xonik/waveshaper-pcb/Xonik Waveshaper v2.2-brd.md

# Xonik Waveshaper v2.2

### Board top
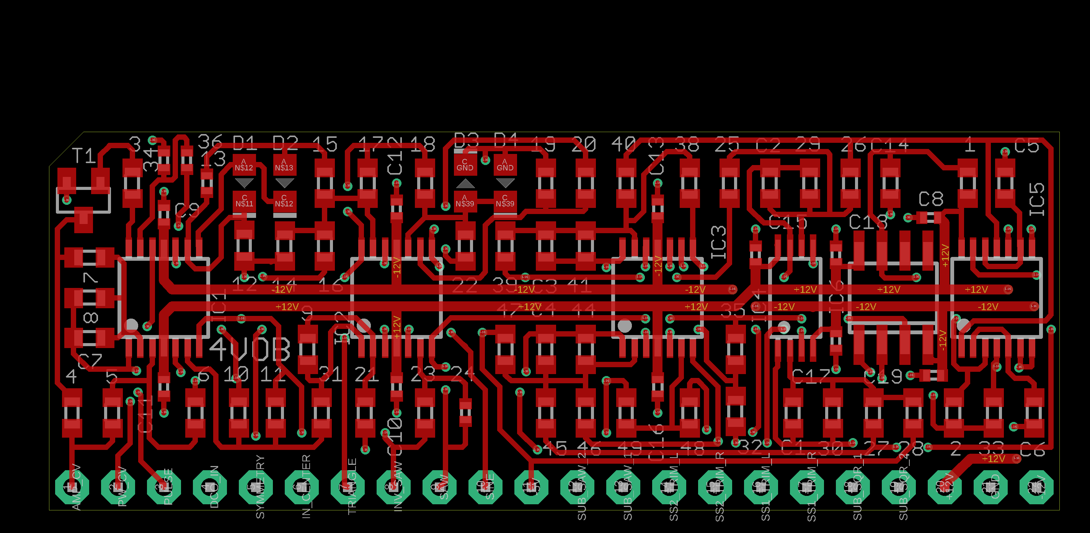
[picture p1: Xonik Waveshaper v2.2-brd-top.png]
Top side

### Board bottom
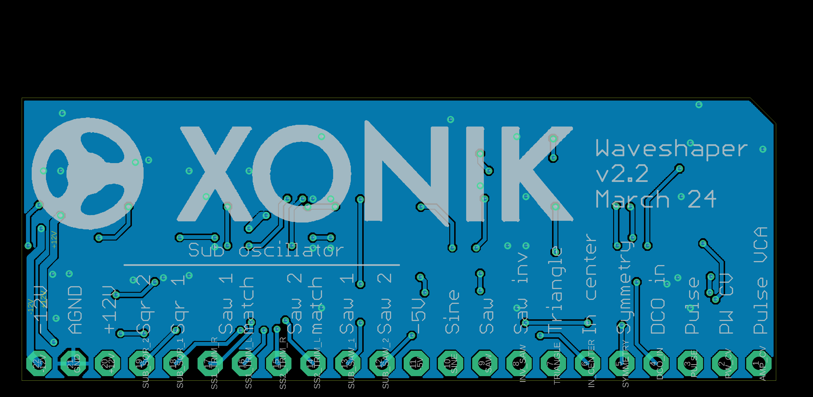
[picture p2: Xonik Waveshaper v2.2-brd-bottom.png]
Bottom side
