xonik/waveshaper-pcb/Xonik Waveshaper v2.4-brd.md

# Xonik Waveshaper v2.4

### Board top
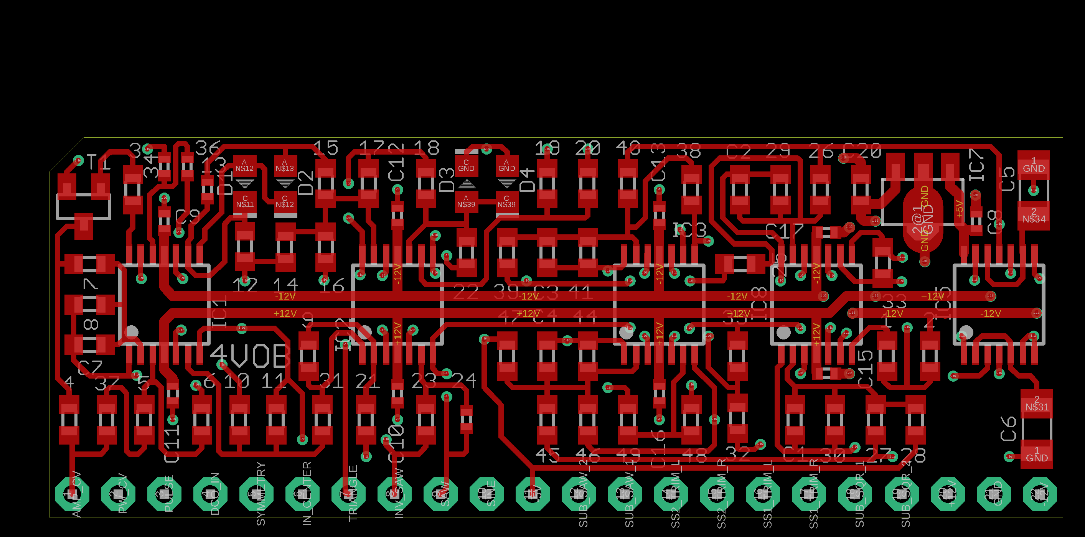
[picture p3: Xonik Waveshaper v2.4-brd-top.png]
Top side

### Board bottom
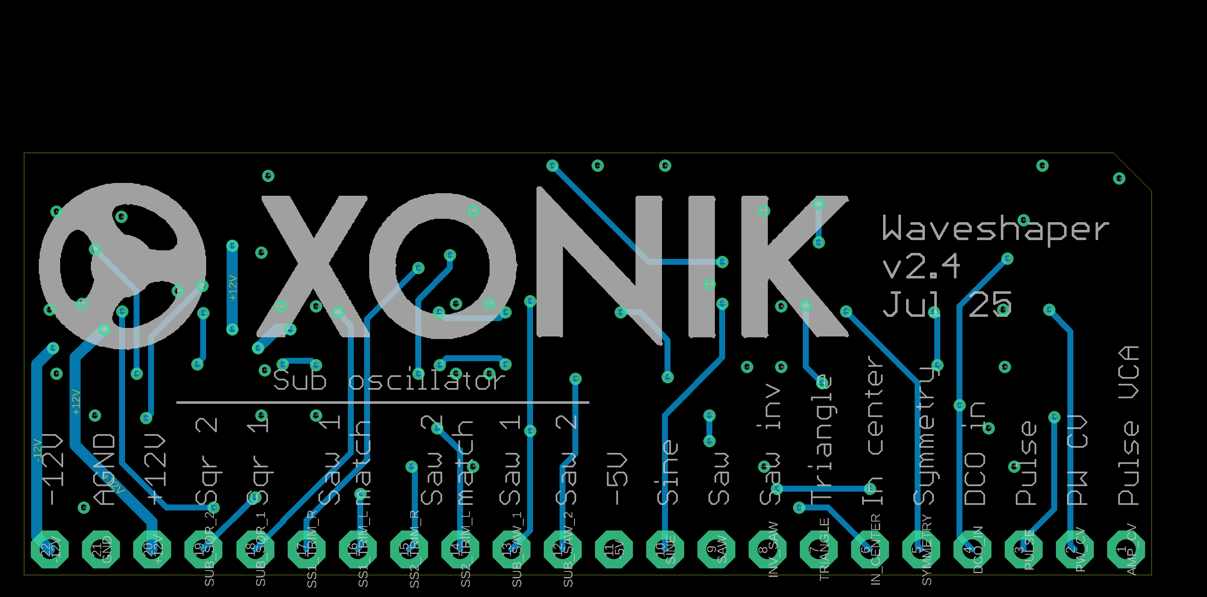
[picture p4: Xonik Waveshaper v2.4-brd-bottom.png]
Bottom side
