xonik/waveshaper-pcb/attic/Xonik Waveshaper v2.1-brd.md

# Xonik Waveshaper v2.1

### Board top
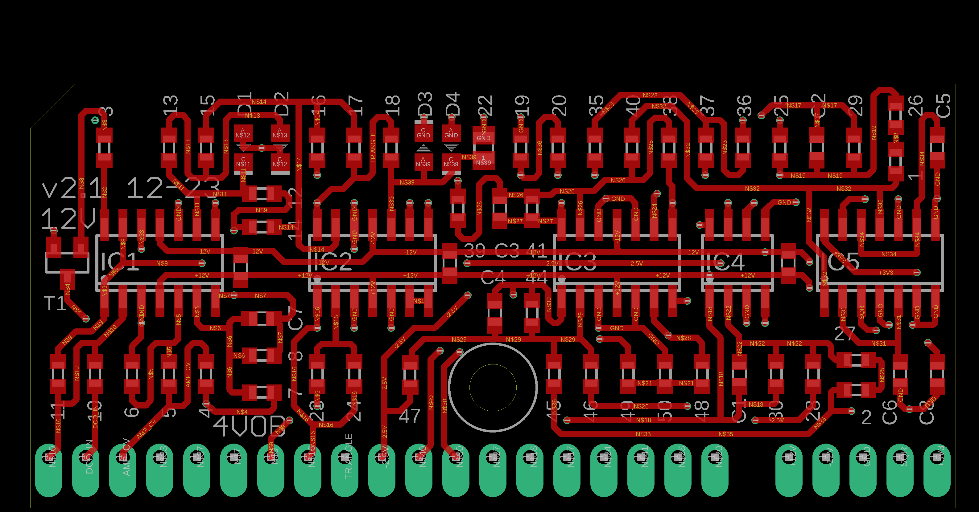
[picture p5: attic/Xonik Waveshaper v2.1-brd-top.png]
Top side

### Board bottom
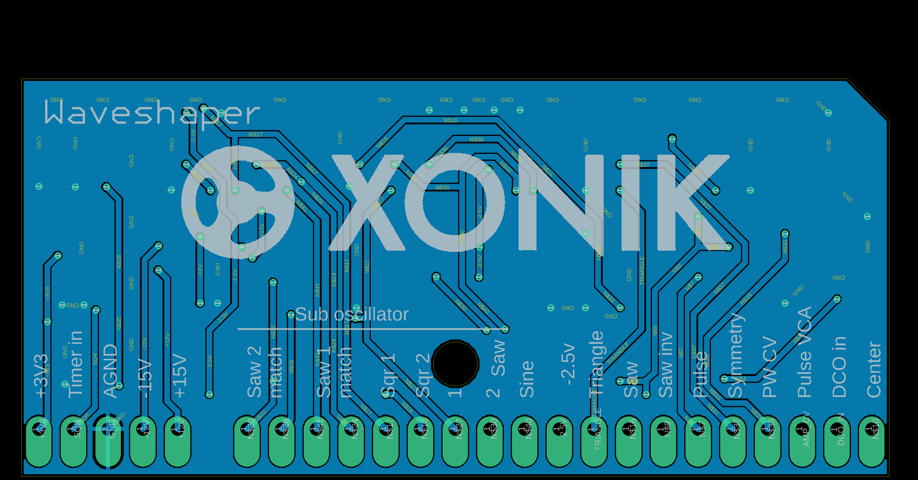
[picture p6: attic/Xonik Waveshaper v2.1-brd-bottom.png]
Bottom side
