xonik/waveshaper-pcb/Xonik Waveshaper v2.4-sch.md

# Xonik Waveshaper v2.4

### Sheet 1

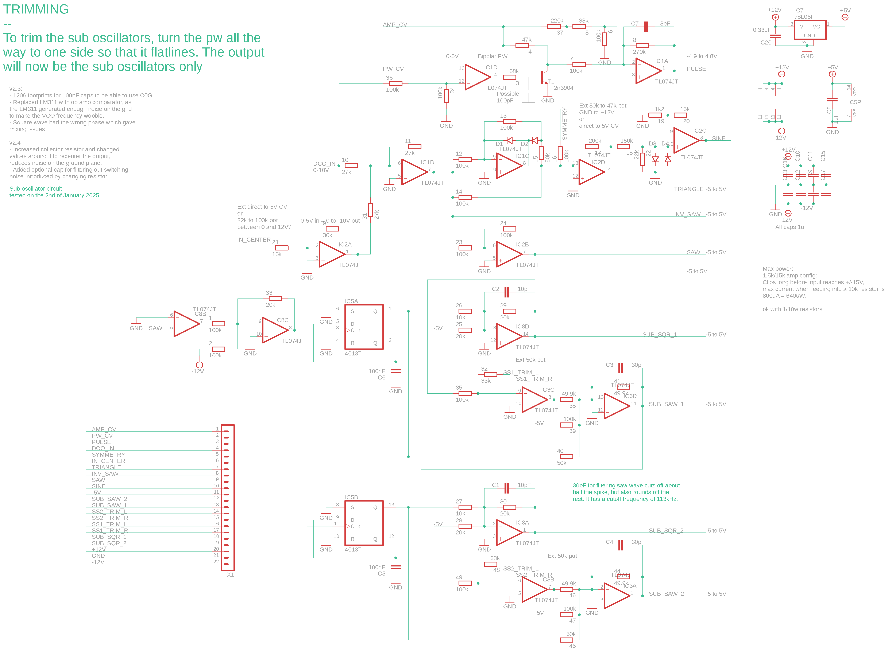
[picture p7: Xonik Waveshaper v2.4-sch-1.png]
Top side
