xonik/waveshaper-pcb/attic/Xonik Waveshaper v2.1-sch.md

# Xonik Waveshaper v2.1

### Sheet 1

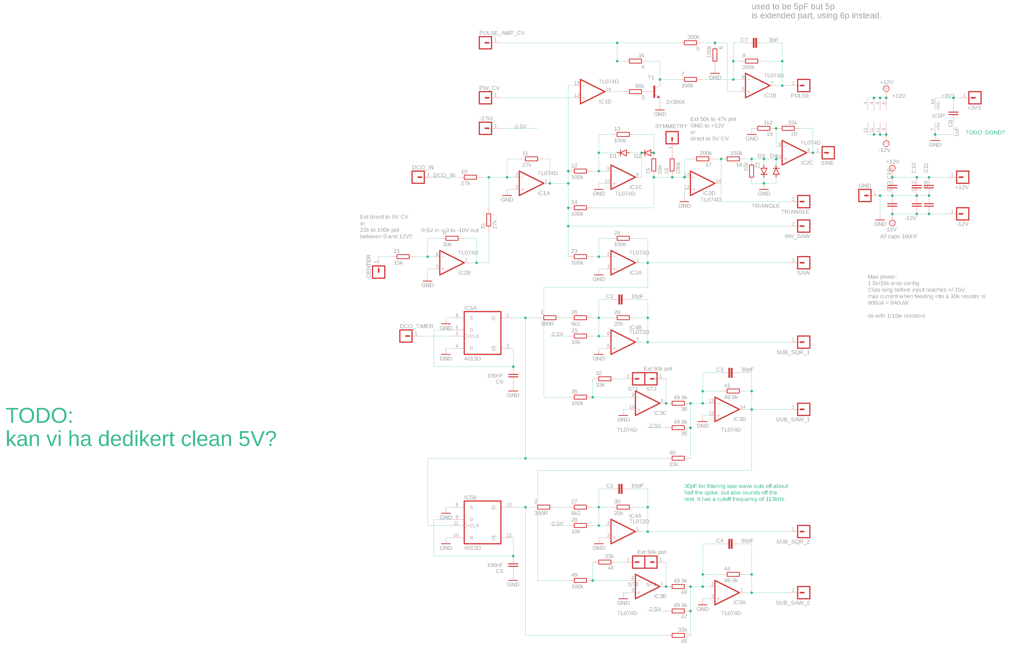
[picture p8: attic/Xonik Waveshaper v2.1-sch-1.png]
Top side
