xonik/waveshaper-pcb/Xonik Waveshaper v2.3-brd.md

# Xonik Waveshaper v2.3

### Board top
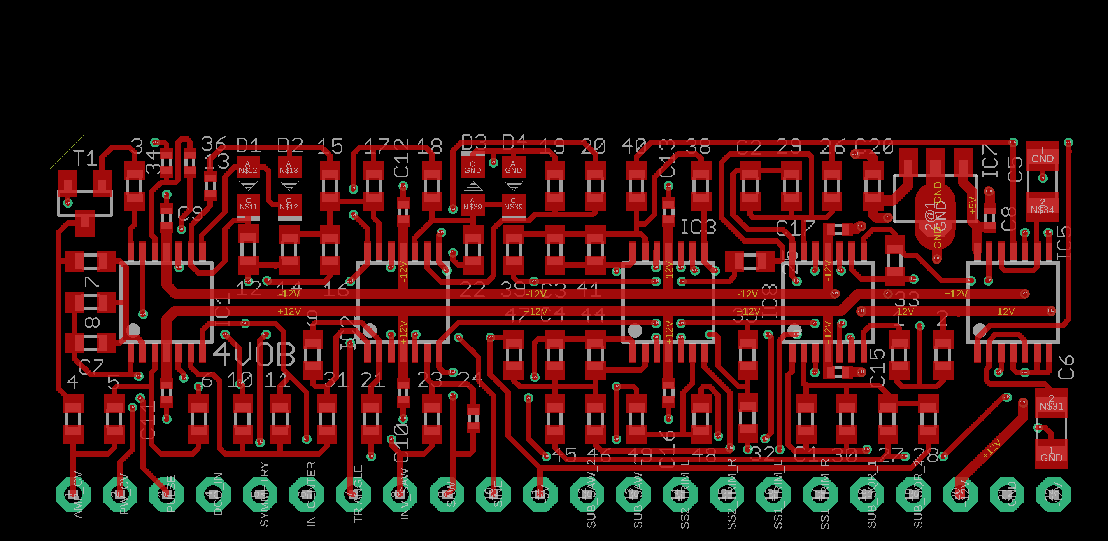
[picture p9: Xonik Waveshaper v2.3-brd-top.png]
Top side

### Board bottom
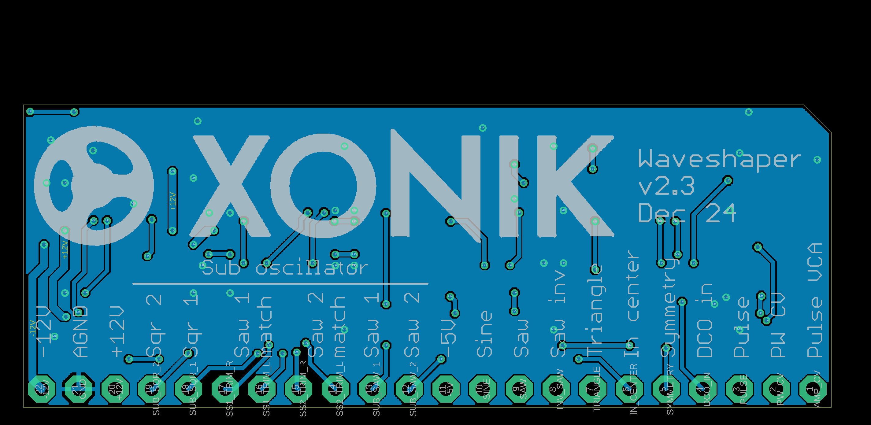
[picture p10: Xonik Waveshaper v2.3-brd-bottom.png]
Bottom side
