xonik/waveshaper-pcb/Xonik Waveshaper v2.3-sch.md

# Xonik Waveshaper v2.3

### Sheet 1

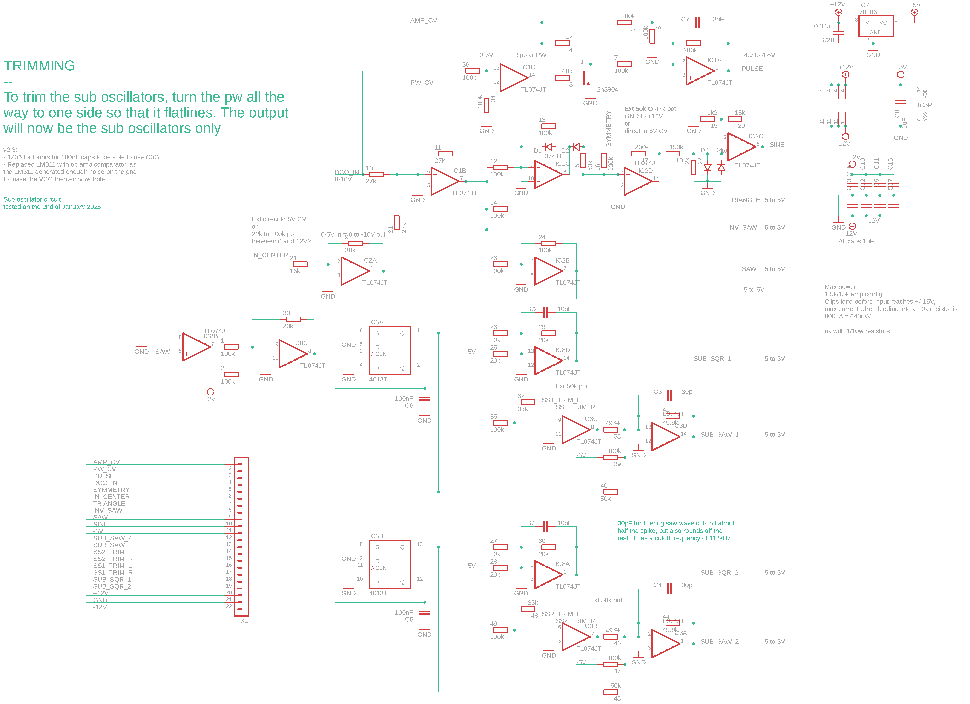
[picture p11: Xonik Waveshaper v2.3-sch-1.png]
Top side
