xonik/waveshaper-pcb/Xonik Waveshaper v2.2-sch.md

# Xonik Waveshaper v2.2

### Sheet 1

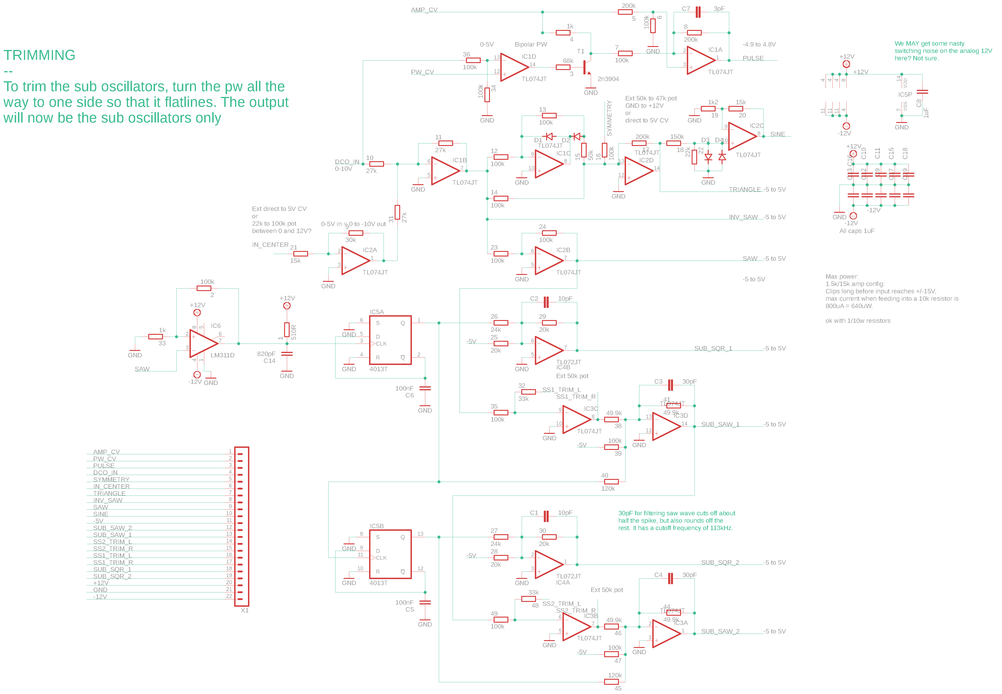
[picture p12: Xonik Waveshaper v2.2-sch-1.png]
Top side
