xonik/waveshaper-pcb/Extended parts.txt

Extended parts, Waveshaper:

50k - C63865
CD4013 - C347580
TL074D

Missing from bom
TL074, IC1,2,3

Wrong rotation:
T1, is 180, should be 90
D1,2,3,4 swapped +/-
