xonik/waveshaper-pcb/Xonik Waveshaper v2.4_top_bom.csv

Comment | Designator | Footprint | LCSC Part #
MA22N-1J | X1 | MA22N-1J
0.33uF | C20 | C0603-J
1N41480805 | D1 D2 D3 D4 | D0805-J
1k2 | 19 | R0603
1uF | C8 C9 C10 C11 C12 C13 C15 C16 C17 | C0402-J
2n3904 | T1 | SOT23-BEC
3pF | C7 | C0603-J
10k | 26 27 | R0603
10pF | C1 C2 | C0603-J
15k | 20 21 | R0603
20k | 25 28 29 30 33 | R0603
22k | 22 | R0603
27k | 10 11 31 | R0603
30k | 9 | R0603
30pF | C3 C4 | C0603-J
33k | 5 32 48 | R0603
47k | 4 | R0603
49.9k | 38 41 44 46 | R0603
50k | 15 40 45 | R0603
68k | 3 | R0603
78L05F | IC7 | SOT89
100k | 1 2 6 7 12 | R0603
100k | 13 | R0402
100k | 14 16 23 | R0603
100k | 24 34 | R0402
100k | 35 | R0603
100k | 36 | R0402
100k | 39 47 49 | R0603
100nF | C5 C6 | C1206
150k | 18 | R0603
200k | 17 | R0603
220k | 37 | R0603
270k | 8 | R0603
4013T | IC5 | TSSOP14J
TL074JT | IC1 IC2 IC3 IC8 | TSSOP14J
