xonik/waveshaper-pcb/Xonik Waveshaper v2.4.brd

## EAGLE design Xonik Waveshaper v2.4.brd (2025-08-01)

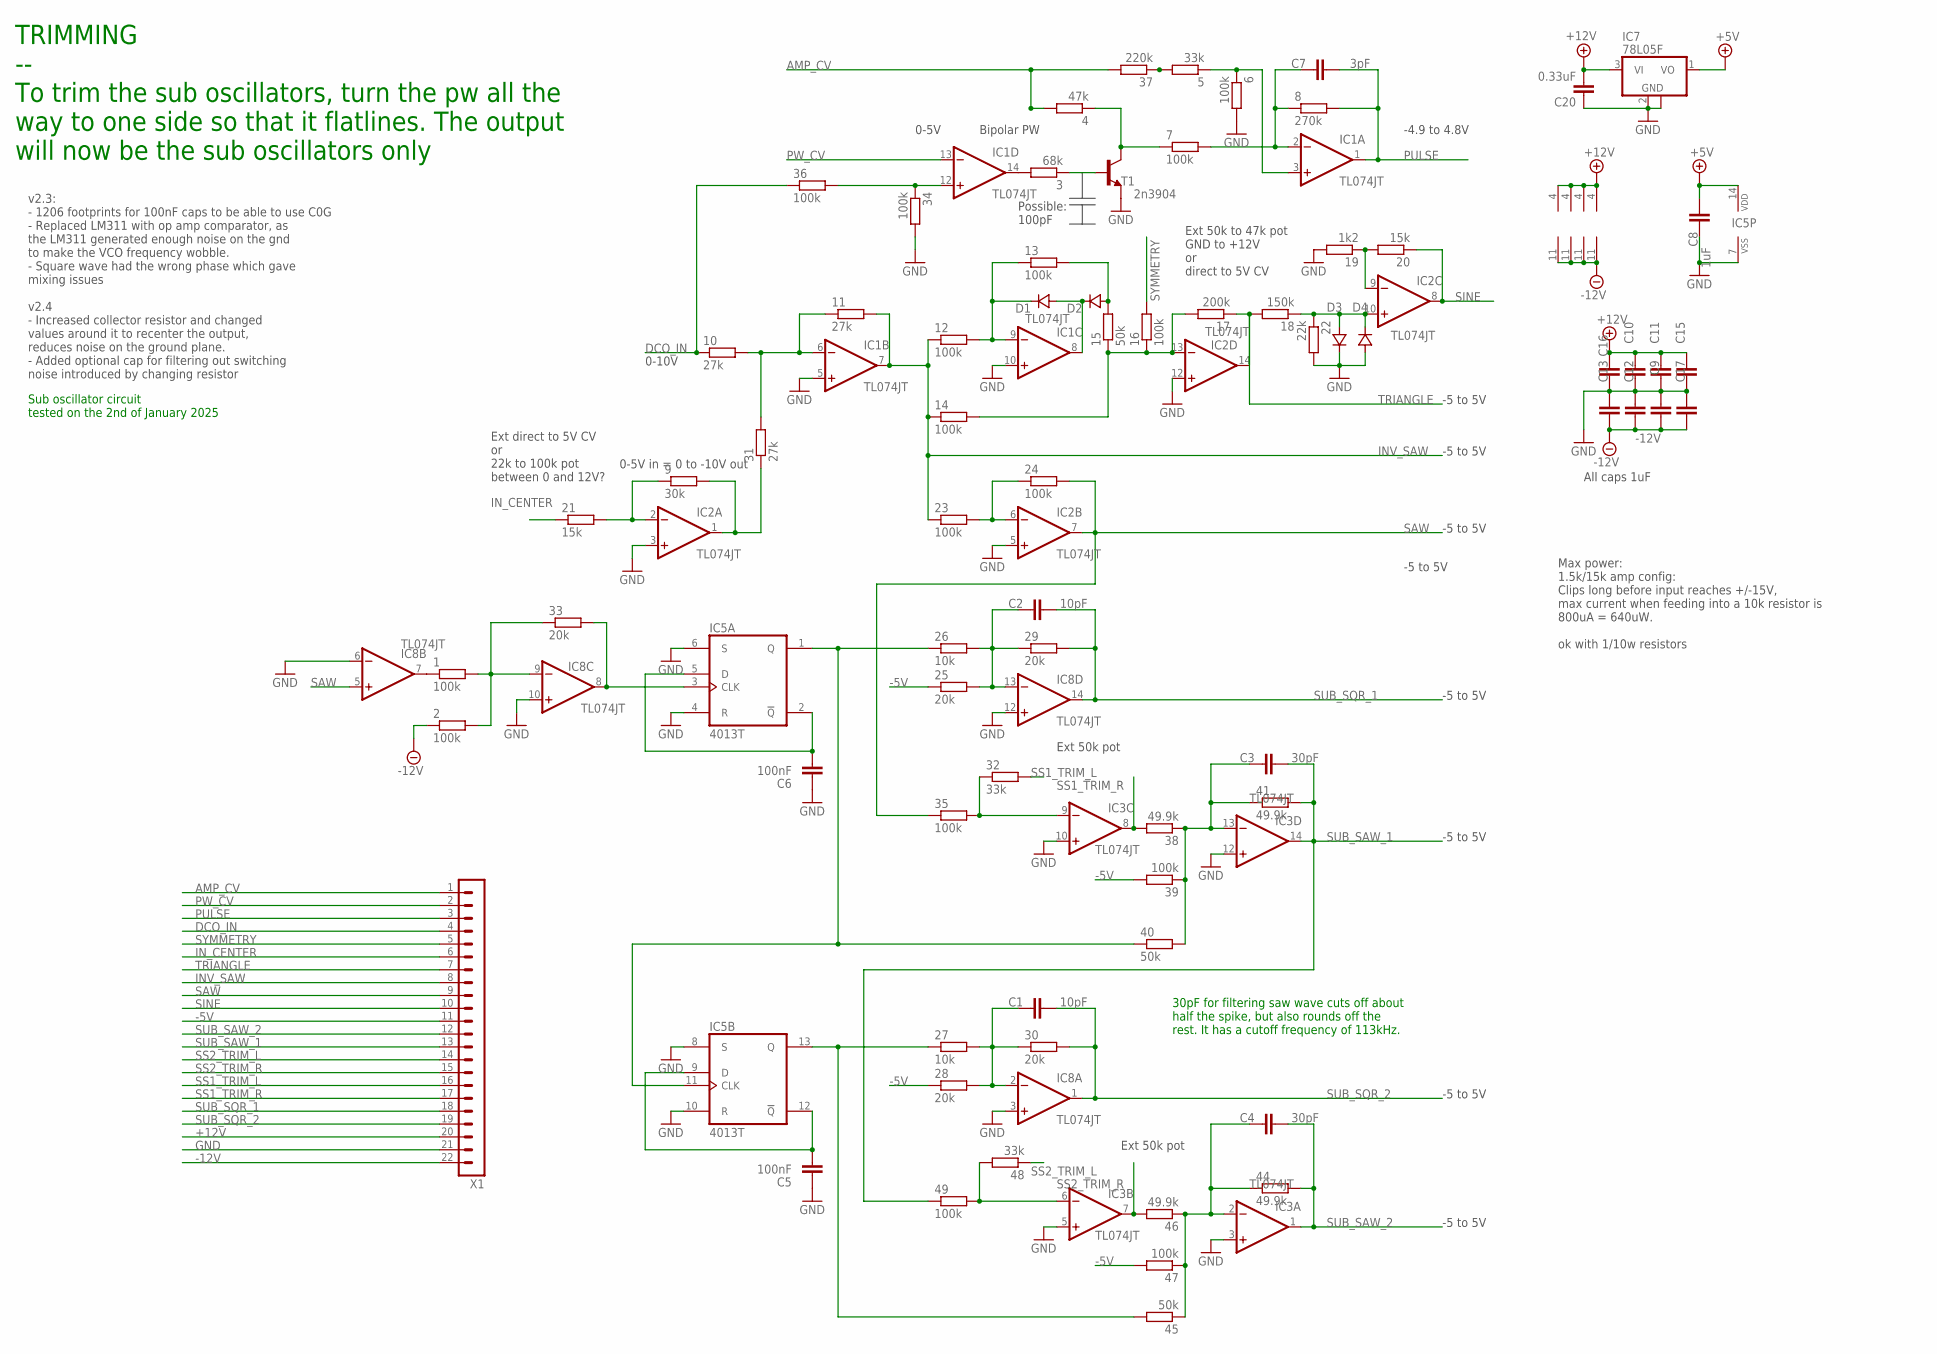
[picture p13: schematic Xonik Waveshaper v2.4.sch]

Parts:
1, 2, 6, 7, 12, 14, 16, 23, 35, 39, 47, 49: 100k; R0603
3: 68k; R0603
4: 47k; R0603
5, 32, 48: 33k; R0603
8: 270k; R0603
9: 30k; R0603
10, 11, 31: 27k; R0603
13, 24, 34, 36: 100k; R0402
15, 40, 45: 50k; R0603
17: 200k; R0603
18: 150k; R0603
19: 1k2; R0603
20, 21: 15k; R0603
22: 22k; R0603
25, 28, 29, 30, 33: 20k; R0603
26, 27: 10k; R0603
37: 220k; R0603
38, 41, 44, 46: 49.9k; R0603
C1, C2: 10pF; C0603-J
C3, C4: 30pF; C0603-J
C5, C6: 100nF; C1206
C7: 3pF; C0603-J
C8, C9, C10, C11, C12, C13, C15, C16, C17: 1uF; C0402-J
C20: 0.33uF; C0603-J
D1, D2, D3, D4: 1N41480805; D0805-J
IC1, IC2, IC3, IC8: TL074JT; TSSOP14J
IC5: 4013T; TSSOP14J
IC7: 78L05F; SOT89
T1: 2n3904; SOT23-BEC
X1: MA22-1JN; MA22N-1J

Connections:
+5V: C8.2, IC5.14 (VDD), IC7.1 (VO)
+12V: C10.2, C11.2, C15.2, C16.2, C20.2, IC1.4 (V+), IC2.4 (V+), IC3.4 (V+), IC7.3 (VI), IC8.4 (V+), X1.20
-5V: 25.1, 28.1, 39.2, 47.2, X1.11
-12V: 2.1, C9.1, C12.1, C13.1, C17.1, IC1.11 (V-), IC2.11 (V-), IC3.11 (V-), IC8.11 (V-), X1.22
AMP_CV: 4.2, 37.2, X1.1
DCO_IN: 10.1, 36.1, X1.4
GND: 6.2, 19.2, 22.2, 34.2, C5.1, C6.1, C8.1, C9.2, C10.1, C11.1, C12.2, C13.2, C15.1, C16.1, C17.2, C20.1, D3.C, D4.A, IC1.5 (+IN), IC1.10 (+IN), IC2.3 (+IN), IC2.5 (+IN), IC2.12 (+IN), IC3.3 (+IN), IC3.5 (+IN), IC3.10 (+IN), IC3.12 (+IN), IC5.4 (R), IC5.6 (S), IC5.7 (VSS), IC5.8 (S), IC5.10 (R), IC7.2 (GND), IC7.2@1 (GND), IC8.3 (+IN), IC8.6 (-IN), IC8.10 (+IN), IC8.12 (+IN), T1.E, X1.21
INV_SAW: 11.2, 12.1, 14.1, 23.1, IC1.7 (OUT), X1.8
IN_CENTER: 21.1, X1.6
unnamed: 9.1, 21.2, IC2.2 (-IN)
unnamed: 3.2, IC1.14 (OUT)
unnamed: 3.1, T1.B
unnamed: 4.1, 7.1, T1.C
unnamed: 5.1, 6.1, IC1.3 (+IN)
unnamed: 7.2, 8.1, C7.1, IC1.2 (-IN)
unnamed: 1.1, IC8.7 (OUT)
unnamed: 34.1, 36.2, IC1.12 (+IN)
unnamed: 1.2, 2.2, 33.1, IC8.9 (-IN)
unnamed: 10.2, 11.1, 31.2, IC1.6 (-IN)
unnamed: 12.2, 13.1, D1.C, IC1.9 (-IN)
unnamed: D1.A, D2.C, IC1.8 (OUT)
unnamed: 13.2, 15.2, D2.A
unnamed: 14.2, 15.1, 16.1, 17.2, IC2.13 (-IN)
unnamed: 23.2, 24.1, IC2.6 (-IN)
unnamed: 5.2, 37.1
unnamed: 33.2, IC5.3 (CLK), IC8.8 (OUT)
unnamed: 25.2, 26.2, 29.1, C2.1, IC8.13 (-IN)
unnamed: 48.2, 49.2, IC3.6 (-IN)
unnamed: 27.2, 28.2, 30.1, C1.1, IC8.2 (-IN)
unnamed: 32.1, 35.2, IC3.9 (-IN)
unnamed: 38.1, 39.1, 40.2, 41.1, C3.1, IC3.13 (-IN)
unnamed: 44.1, 45.1, 46.1, 47.1, C4.1, IC3.2 (-IN)
unnamed: C6.2, IC5.2 (!Q), IC5.5 (D)
unnamed: 26.1, 40.1, IC5.1 (Q), IC5.11 (CLK)
unnamed: C5.2, IC5.9 (D), IC5.12 (!Q)
unnamed: 27.1, 45.2, IC5.13 (Q)
unnamed: 19.1, 20.2, IC2.9 (-IN)
unnamed: 18.1, 22.1, D3.A, D4.C, IC2.10 (+IN)
unnamed: 9.2, 31.1, IC2.1 (OUT)
PULSE: 8.2, C7.2, IC1.1 (OUT), X1.3
PW_CV: IC1.13 (-IN), X1.2
SAW: 24.2, 35.1, IC2.7 (OUT), IC8.5 (+IN), X1.9
SINE: 20.1, IC2.8 (OUT), X1.10
SS1_TRIM_L: 32.2, X1.16
SS1_TRIM_R: 38.2, IC3.8 (OUT), X1.17
SS2_TRIM_L: 48.1, X1.14
SS2_TRIM_R: 46.2, IC3.7 (OUT), X1.15
SUB_SAW_1: 41.2, 49.1, C3.2, IC3.14 (OUT), X1.13
SUB_SAW_2: 44.2, C4.2, IC3.1 (OUT), X1.12
SUB_SQR_1: 29.2, C2.2, IC8.14 (OUT), X1.18
SUB_SQR_2: 30.2, C1.2, IC8.1 (OUT), X1.19
SYMMETRY: 16.2, X1.5
TRIANGLE: 17.1, 18.2, IC2.14 (OUT), X1.7

Notes on the sheet:
All caps 1uF
Ext direct to 5V CV or 22k to 100k pot between 0 and 12V?
Ext 50k to 47k pot GND to +12V or direct to 5V CV
Ext 50k pot
30pF for filtering saw wave cuts off about half the spike, but also rounds off the rest. It has a cutoff frequency of 113kHz.
Max power: 1.5k/15k amp config: Clips long before input reaches +/-15V, max current when feeding into a 10k resistor is 800uA = 640uW. ok with 1/10w resistors
0-5V in = 0 to -10V out
0-10V
0-5V
-4.9 to 4.8V
Bipolar PW
-5 to 5V
TRIMMING -- To trim the sub oscillators, turn the pw all the way to one side so that it flatlines. The output will now be the sub oscillators only
v2.3: - 1206 footprints for 100nF caps to be able to use C0G - Replaced LM311 with op amp comparator, as the LM311 generated enough noise on the gnd to make the VCO frequency wobble. - Square wave had the wrong phase which gave mixing issues v2.4 - Increased collector resistor and changed values ar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
Sub oscillator circuit tested on the 2nd of January 2025
Possible: 100pF

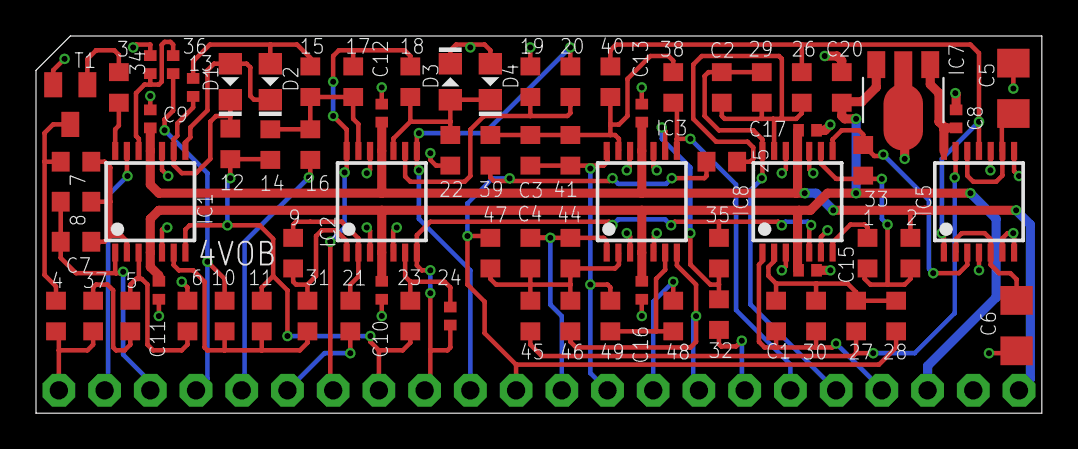
[picture p14: board Xonik Waveshaper v2.4.brd from above]

Board: 4 copper layers, 55.9 x 21.0 mm, 77 parts (1 on the bottom side), 53 nets.

Other parts of the board:
U$1: XONIK_LOGO_40
