xonik/waveshaper-pcb/attic/Xonik Waveformer v1.0.brd

## EAGLE design attic/Xonik Waveformer v1.0.brd (2017-09-30)

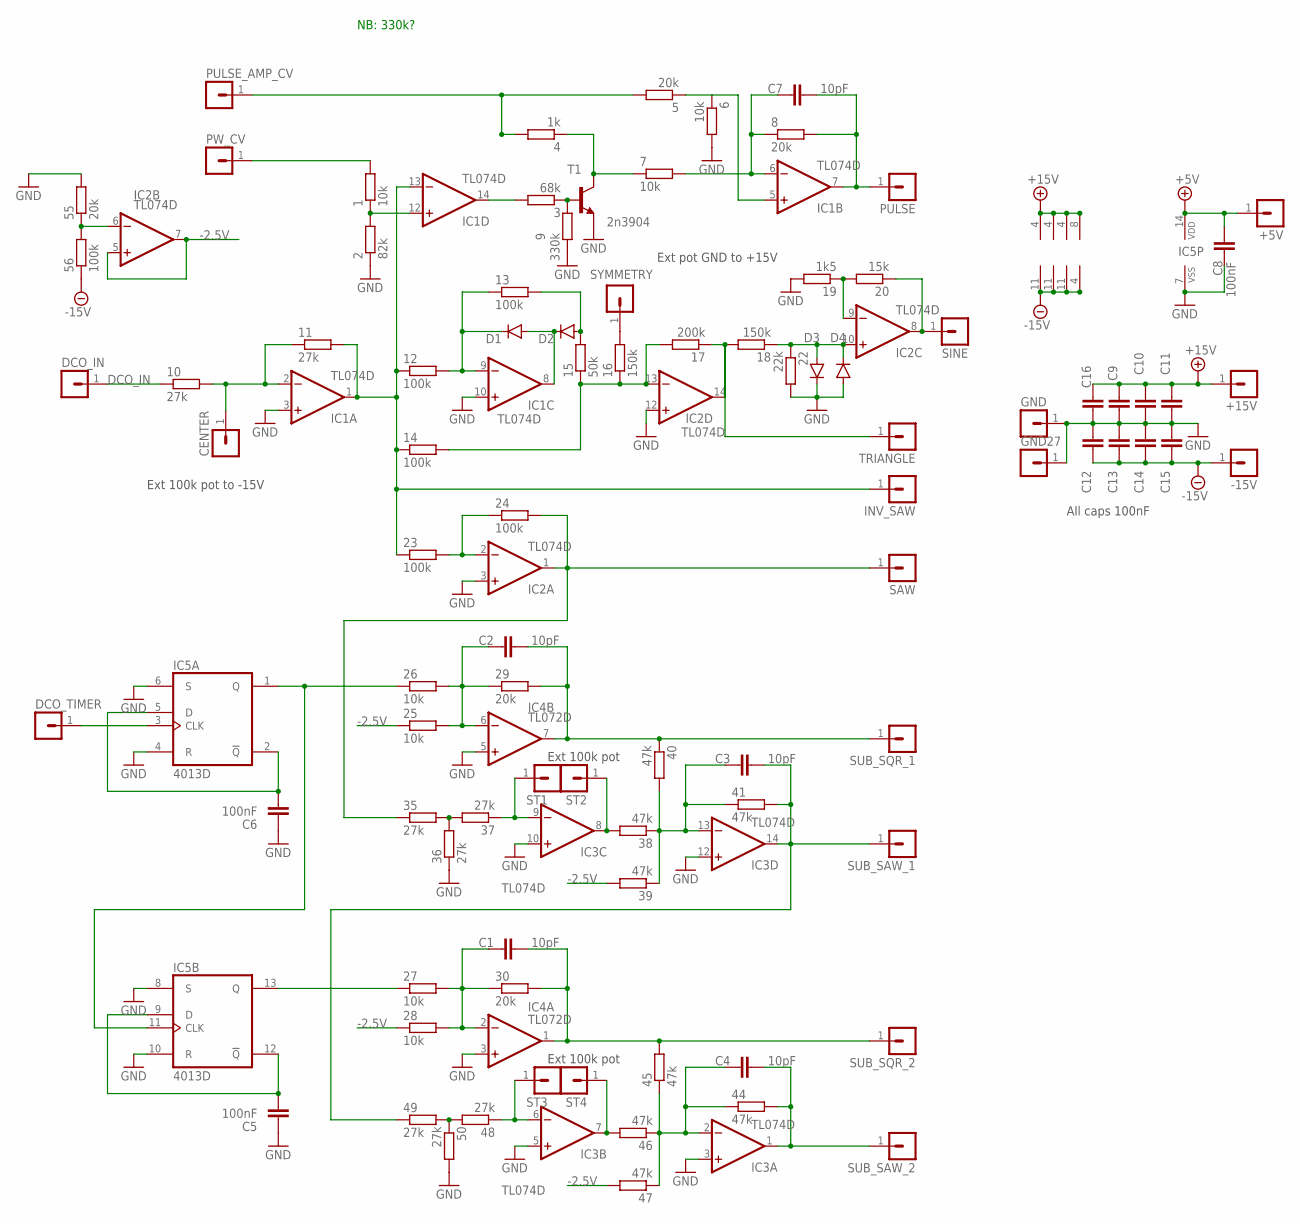
[picture p15: schematic Xonik Waveformer v1.0.sch]

Parts:
1, 6, 7, 25, 26, 27, 28: 10k; R0805
2: 82k; R0805
3: 68k; R0805
4: 1k; R0805
5, 8, 29, 30, 55: 20k; R0805
9: 330k; R0805
10, 11, 35, 36, 37, 48, 49, 50: 27k; R0805
12, 13, 14, 23, 24, 56: 100k; R0805
15: 50k; R0805
16, 18: 150k; R0805
17: 200k; R0805
19: 1k5; R0805
20: 15k; R0805
22: 22k; R0805
38, 39, 40, 41, 44, 45, 46, 47: 47k; R0805
+5V, +15V: MA01-1JP; SIP-PIN01-1J
-15V: MA01-1JP; SIP-PIN01-1J
C1, C2, C3, C4, C7: 10pF; C0805
C5, C6, C8: 100nF; C0805
C9, C10, C11, C12, C13, C14, C15, C16: 100nF; C0603K
CENTER: MA01-1JP; SIP-PIN01-1J
D1, D2, D3, D4: 1N41480805; D0805-J
DCO_IN: MA01-1JP; SIP-PIN01-1J
DCO_TIMER: MA01-1JP; SIP-PIN01-1J
GND, GND27: MA01-1JP; SIP-PIN01-1J
IC1, IC2, IC3: TL074D; SO14
IC4: TL072D; SO08J
IC5: 4013D; SO14J
INV_SAW: MA01-1JP; SIP-PIN01-1J
PULSE: MA01-1JP; SIP-PIN01-1J
PULSE_AMP_CV: MA01-1JP; SIP-PIN01-1J
PW_CV: MA01-1JP; SIP-PIN01-1J
SAW: MA01-1JP; SIP-PIN01-1J
SINE: MA01-1JP; SIP-PIN01-1J
ST1, ST2, ST3, ST4: MA01-1JP; SIP-PIN01-1J
SUB_SAW_1, SUB_SAW_2: MA01-1JP; SIP-PIN01-1J
SUB_SQR_1, SUB_SQR_2: MA01-1JP; SIP-PIN01-1J
SYMMETRY: MA01-1JP; SIP-PIN01-1J
T1: 2n3904; SOT23-BEC
TRIANGLE: MA01-1JP; SIP-PIN01-1J

Connections:
+5V: +5V.1, C8.2, IC5.14 (VDD)
+15V: +15V.1, C9.2, C10.2, C11.2, C16.2, IC1.4 (V+), IC2.4 (V+), IC3.4 (V+), IC4.8 (V+)
-2.5V: 25.1, 28.1, 39.2, 47.2, IC2.5 (+IN), IC2.7 (OUT)
-15V: 56.1, -15V.1, C12.1, C13.1, C14.1, C15.1, IC1.11 (V-), IC2.11 (V-), IC3.11 (V-), IC4.4 (V-)
AMP_CV: 4.2, 5.2, PULSE_AMP_CV.1
DCO_IN: 10.1, DCO_IN.1
GND: 2.1, 6.2, 9.2, 19.2, 22.2, 36.1, 50.2, 55.2, C5.1, C6.1, C8.1, C9.1, C10.1, C11.1, C12.2, C13.2, C14.2, C15.2, C16.1, D3.C, D4.A, GND.1, GND27.1, IC1.3 (+IN), IC1.10 (+IN), IC2.3 (+IN), IC2.12 (+IN), IC3.3 (+IN), IC3.5 (+IN), IC3.10 (+IN), IC3.12 (+IN), IC4.3 (+IN), IC4.5 (+IN), IC5.4 (R), IC5.6 (S), IC5.7 (VSS), IC5.8 (S), IC5.10 (R), T1.E
unnamed: 1.1, 2.2, IC1.12 (+IN)
unnamed: 3.2, IC1.14 (OUT)
unnamed: 3.1, 9.1, T1.B
unnamed: 4.1, 7.1, T1.C
unnamed: 5.1, 6.1, IC1.5 (+IN)
unnamed: 7.2, 8.1, C7.1, IC1.6 (-IN)
unnamed: 8.2, C7.2, IC1.7 (OUT), PULSE.1
unnamed: 11.2, 12.1, 14.1, 23.1, IC1.1 (OUT), IC1.13 (-IN), INV_SAW.1
unnamed: 10.2, 11.1, CENTER.1, IC1.2 (-IN)
unnamed: 12.2, 13.1, D1.C, IC1.9 (-IN)
unnamed: D1.A, D2.C, IC1.8 (OUT)
unnamed: 13.2, 15.2, D2.A
unnamed: 14.2, 15.1, 16.1, 17.2, IC2.13 (-IN)
unnamed: 23.2, 24.1, IC2.2 (-IN)
unnamed: 24.2, 35.1, IC2.1 (OUT), SAW.1
unnamed: 29.2, 40.1, C2.2, IC4.7 (OUT), SUB_SQR_1.1
unnamed: 30.2, 45.2, C1.2, IC4.1 (OUT), SUB_SQR_2.1
unnamed: 25.2, 26.2, 29.1, C2.1, IC4.6 (-IN)
unnamed: 46.2, IC3.7 (OUT), ST4.1
unnamed: 48.2, 49.2, 50.1
unnamed: 27.2, 28.2, 30.1, C1.1, IC4.2 (-IN)
unnamed: 35.2, 36.2, 37.2
unnamed: 37.1, IC3.9 (-IN), ST1.1
unnamed: 38.1, 39.1, 40.2, 41.1, C3.1, IC3.13 (-IN)
unnamed: 41.2, 49.1, C3.2, IC3.14 (OUT), SUB_SAW_1.1
unnamed: 48.1, IC3.6 (-IN), ST3.1
unnamed: 44.1, 45.1, 46.1, 47.1, C4.1, IC3.2 (-IN)
unnamed: 44.2, C4.2, IC3.1 (OUT), SUB_SAW_2.1
unnamed: C6.2, IC5.2 (!Q), IC5.5 (D)
unnamed: 26.1, IC5.1 (Q), IC5.11 (CLK)
unnamed: 55.1, 56.2, IC2.6 (-IN)
unnamed: C5.2, IC5.9 (D), IC5.12 (!Q)
unnamed: 27.1, IC5.13 (Q)
unnamed: 19.1, 20.2, IC2.9 (-IN)
unnamed: 16.2, SYMMETRY.1
unnamed: 17.1, 18.2, IC2.14 (OUT), TRIANGLE.1
unnamed: 18.1, 22.1, D3.A, D4.C, IC2.10 (+IN)
unnamed: 20.1, IC2.8 (OUT), SINE.1
unnamed: 38.2, IC3.8 (OUT), ST2.1
PW_CV: 1.2, PW_CV.1
SQR: DCO_TIMER.1, IC5.3 (CLK)

Notes on the sheet:
NB: 330k?
All caps 100nF
Ext 100k pot to -15V
Ext pot GND to +15V
Ext 100k pot

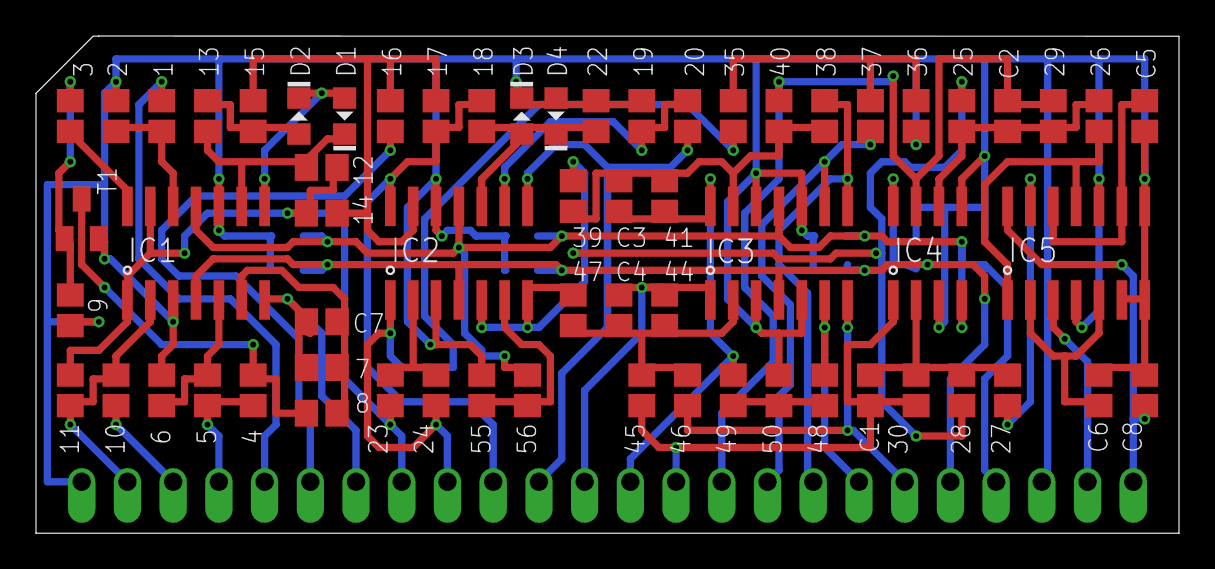
[picture p16: board Xonik Waveformer v1.0.brd from above]

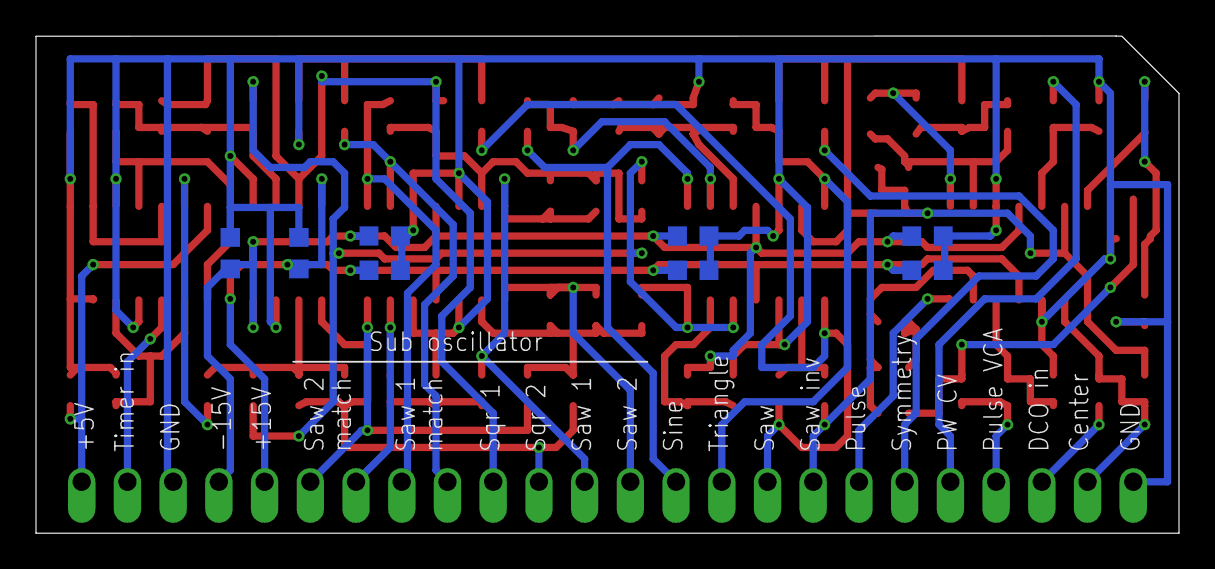
[picture p17: board Xonik Waveformer v1.0.brd from below]

Board: 2 copper layers, 63.5 x 27.6 mm, 95 parts (8 on the bottom side), 48 nets.
