xonik/waveshaper-pcb/attic/Xonik Waveshaper v1.0 w gp panelized 2 ordered 20171010.brd

## EAGLE design attic/Xonik Waveshaper v1.0 w gp panelized 2 ordered 20171010.brd (2018-01-27)

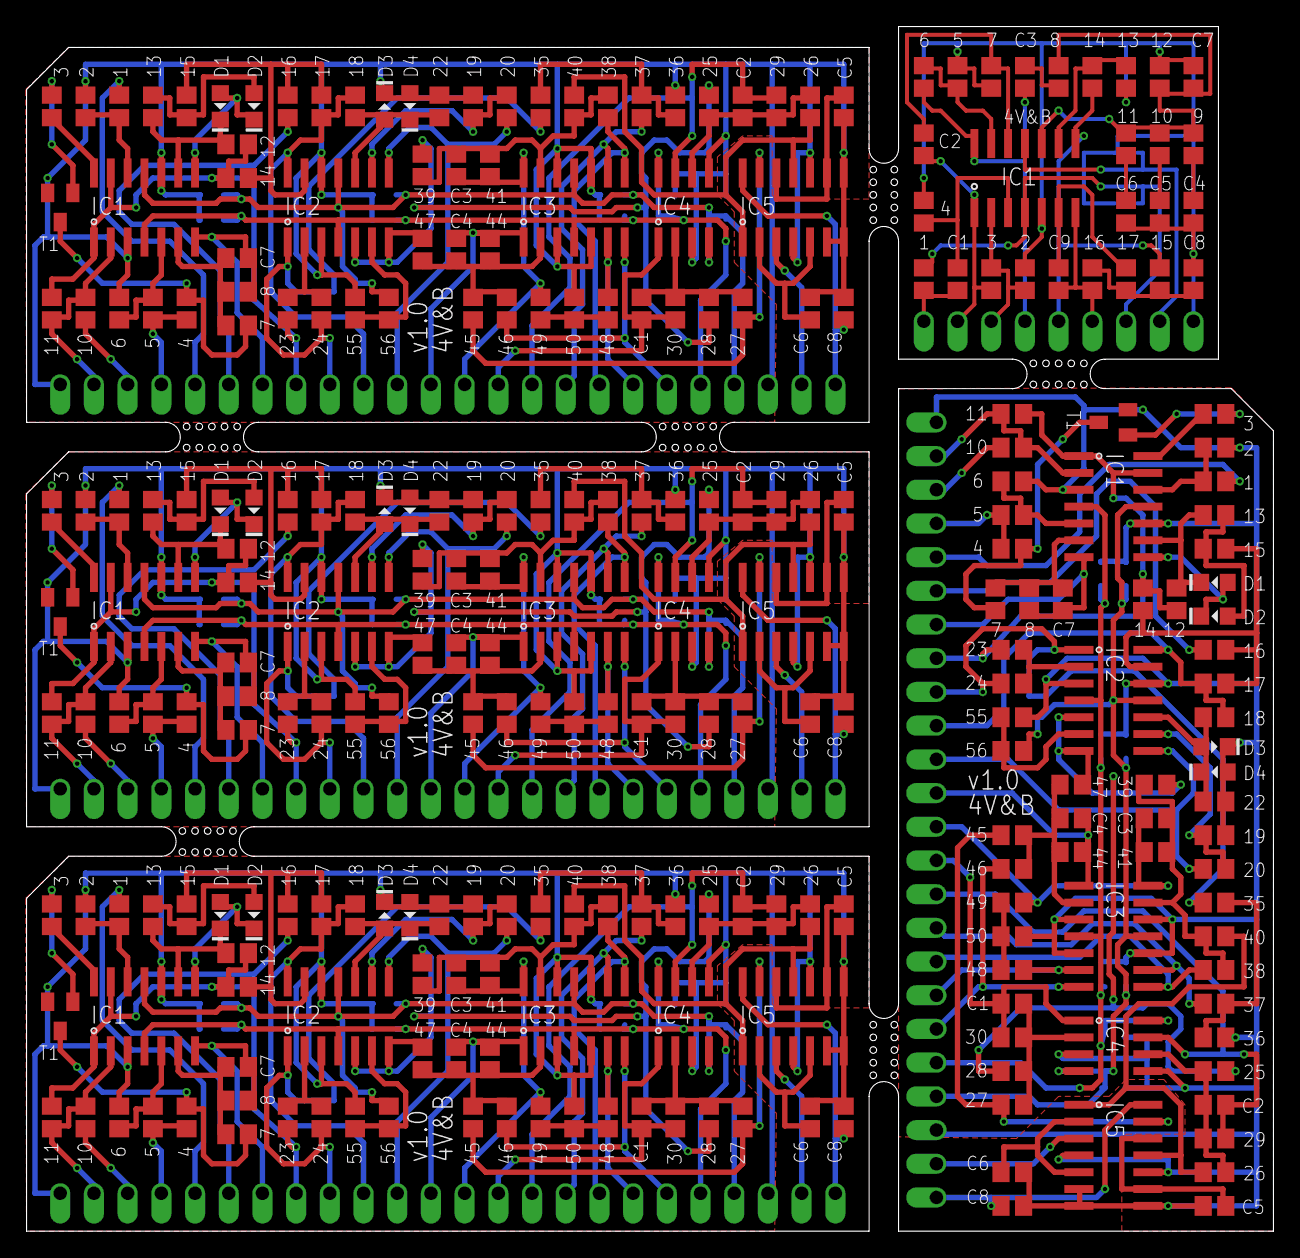
[picture p18: board Xonik Waveshaper v1.0 w gp panelized 2 ordered 20171010.brd from above]

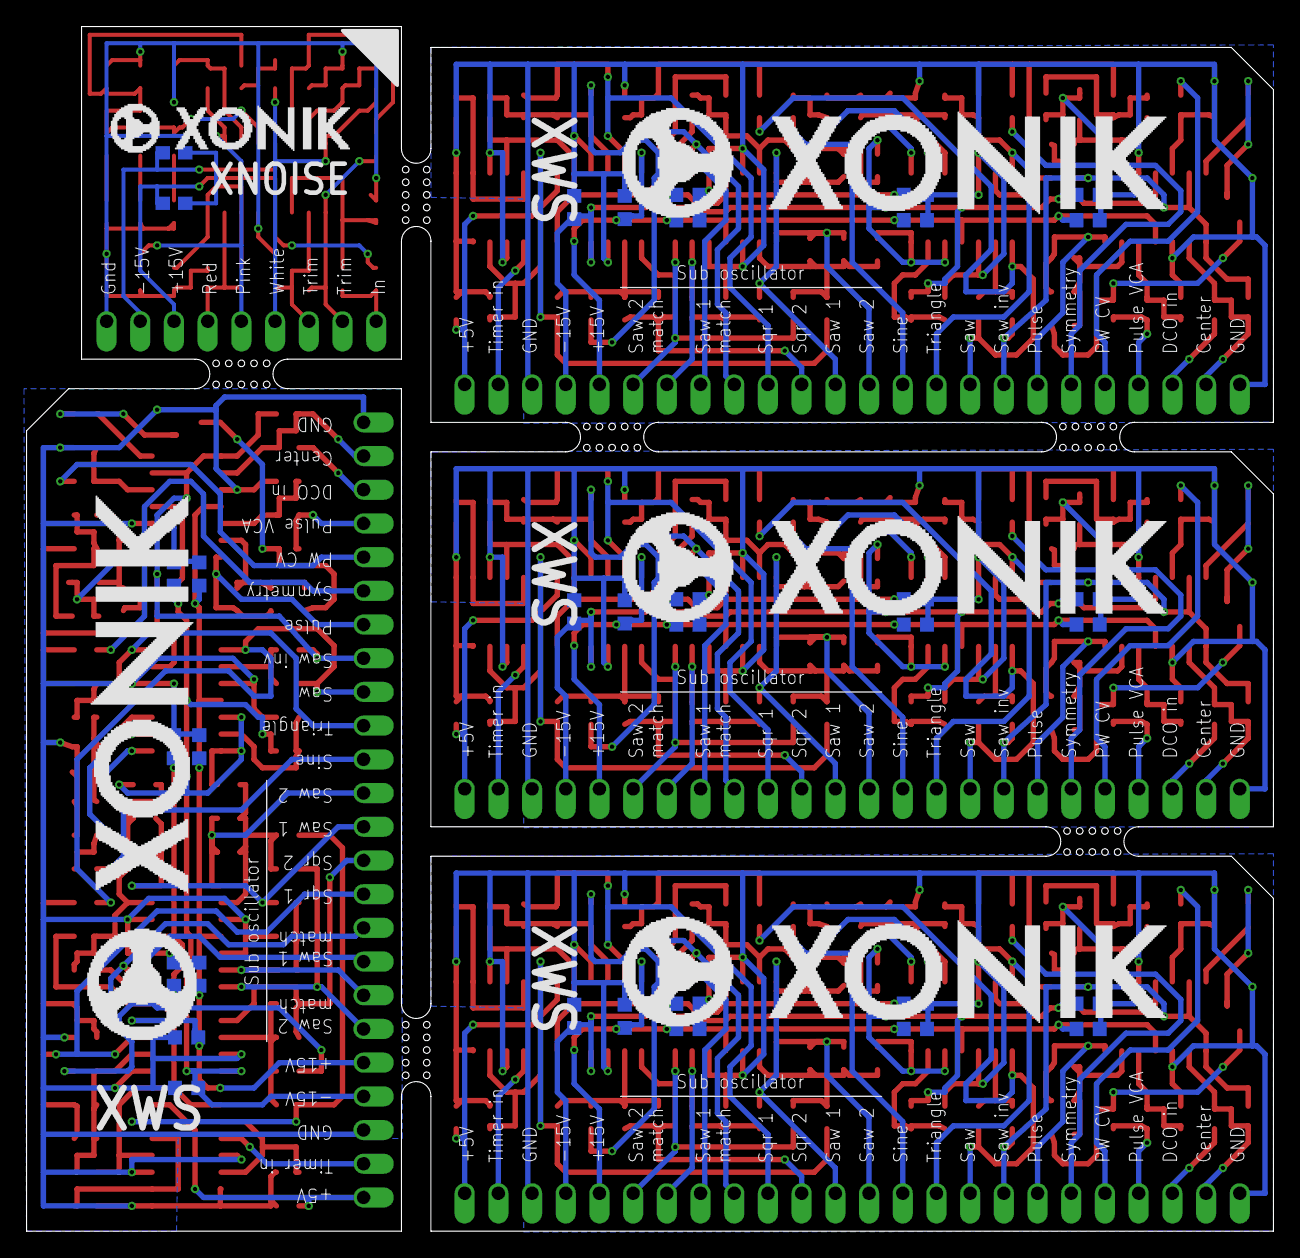
[picture p19: board Xonik Waveshaper v1.0 w gp panelized 2 ordered 20171010.brd from below]

Board: 2 copper layers, 94.0 x 90.8 mm, 414 parts (34 on the bottom side), 212 nets.

Parts:
1, 6, 7, 9, 25, 26, 27, 28, 34, 42, 67, 68, 69, 70, 89, 94, 95, 111, 112, 113, 114, 133, 138, 139, 155, 156, 157, 158, 186: 10k; R0805
2, 21, 90, 134: 82k; R0805
3, 31, 91, 135, 184: 68k; R0805
4, 32, 92, 136, 178, 181, 189: 1k; R0805
5, 8, 29, 30, 33, 43, 55, 71, 72, 87, 93, 96, 115, 116, 131, 137, 140, 159, 160, 175, 179, 182, 190: 20k; R0805
10, 11, 35, 36, 37, 48, 49, 50, 51, 52, 73, 74, 75, 84, 85, 86, 97, 98, 117, 118, 119, 128, 129, 130, 141, 142, 161, 162, 163, 172, 173, 174: 27k; R0805
12, 13, 14, 23, 24, 53, 54, 56, 57, 65, 66, 88, 99, 100, 101, 109, 110, 132, 143, 144, 145, 153, 154, 176, 180, 183: 100k; R0805
15, 58, 102, 146: 50k; R0805
16, 18, 59, 61, 103, 105, 147, 149: 150k; R0805
17, 60, 104, 148: 200k; R0805
19, 62, 106, 150: 1k5; R0805
20, 63, 107, 151, 192: 15k; R0805
22, 64, 108, 152: 22k; R0805
38, 39, 40, 41, 44, 45, 46, 47, 76, 77, 78, 79, 80, 81, 82, 83, 120, 121, 122, 123, 124, 125, 126, 127, 164, 165, 166, 167, 168, 169, 170, 171: 47k; R0805
177: 220k; R0805
185: 33.2k; R0805
187: 3k; R0805
188: 1M; R0805
191: 4k7; R0805
193: 301k; R0805
+5V, +5V1, +5V2, +5V3, +15V, +15V1, +15V2, +15V3, +15V4: SIP-PIN01-1J
-15V, -15V1, -15V2, -15V3, -15V4: SIP-PIN01-1J
C1, C2, C17, C18, C33, C34, C49, C50: 10pF; C0805
C3, C4, C19, C20, C35, C36, C51, C52: ?pF; C0805
C5, C6, C8, C21, C22, C32, C37, C38, C48, C53, C54, C64: 100nF; C0805
C7, C23, C39, C55: 5pF; C0805
C9, C10, C11, C12, C13, C14, C15, C16, C24, C25, C26, C27, C28, C29, C30, C31, C40, C41, C42, C43, C44, C45, C46, C47, C56, C57, C58, C59, C60, C61, C62, C63: 100nF; C0603K
C65, C66, C67: 470n; C0805
C68: 100n; C0805
C69: 22n; C0805
C70: 10n; C0805
C71: 3n3; C0805
C72: 220n; C0805
C73: 2n2; C0805
C74, C75: C0603
CENTER, CENTER1, CENTER2, CENTER3: SIP-PIN01-1J
D1, D2, D3, D4, D5, D6, D7, D8, D9, D10, D11, D12, D13, D14, D15, D16: 1N41480805; D0805-J
DCO_IN, DCO_IN1, DCO_IN2, DCO_IN3: SIP-PIN01-1J
DCO_TIMER, DCO_TIMER1, DCO_TIMER2, DCO_TIMER3: SIP-PIN01-1J
GND, GND1, GND2, GND3, GND4, GND5, GND6, GND7, GND27: SIP-PIN01-1J
IC1, IC2, IC3, IC6, IC7, IC8, IC11, IC12, IC13, IC16, IC17, IC18, IC21: TL074D; SO14
IC4, IC10, IC15, IC20: TL072D; SO08J
IC5, IC9, IC14, IC19: 4013D; SO14J
INV_SAW, INV_SAW1, INV_SAW2, INV_SAW3: SIP-PIN01-1J
LEVEL1, LEVEL2: SIP-PIN01-1J
NOISE_IN: SIP-PIN01-1J
PINK_OUT: SIP-PIN01-1J
PULSE, PULSE1, PULSE2, PULSE3: SIP-PIN01-1J
PULSE_AMP_CV, PULSE_AMP_CV1, PULSE_AMP_CV2, PULSE_AMP_CV3: SIP-PIN01-1J
PW_CV, PW_CV1, PW_CV2, PW_CV3: SIP-PIN01-1J
RED_OUT: SIP-PIN01-1J
SAW, SAW1, SAW2, SAW3: SIP-PIN01-1J
SINE, SINE1, SINE2, SINE3: SIP-PIN01-1J
ST1, ST2, ST3, ST4, ST5, ST6, ST7, ST8, ST9, ST10, ST11, ST12, ST13, ST14, ST15, ST16: SIP-PIN01-1J
SUB_SAW_1, SUB_SAW_2, SUB_SAW_3, SUB_SAW_4, SUB_SAW_5, SUB_SAW_6, SUB_SAW_7, SUB_SAW_8: SIP-PIN01-1J
SUB_SQR_1, SUB_SQR_2, SUB_SQR_3, SUB_SQR_4, SUB_SQR_5, SUB_SQR_6, SUB_SQR_7, SUB_SQR_8: SIP-PIN01-1J
SYMMETRY, SYMMETRY1, SYMMETRY2, SYMMETRY3: SIP-PIN01-1J
T1, T2, T3, T4: 2n3904; SOT23-BEC
TRIANGLE, TRIANGLE1, TRIANGLE2, TRIANGLE3: SIP-PIN01-1J
WHITE_OUT: SIP-PIN01-1J

Connections:
+5V: +5V.1, C8.2, IC5.14
+5V1: +5V1.1, C32.2, IC9.14
+5V2: +5V2.1, C48.2, IC14.14
+5V3: +5V3.1, C64.2, IC19.14
+15V: +15V.1, C9.2, C10.2, C11.2, C16.2, IC1.4, IC2.4, IC3.4, IC4.8
+15V1: +15V1.1, C24.2, C25.2, C26.2, C27.2, IC6.4, IC7.4, IC8.4, IC10.8
+15V2: +15V2.1, C40.2, C41.2, C42.2, C43.2, IC11.4, IC12.4, IC13.4, IC15.8
+15V3: +15V3.1, C56.2, C57.2, C58.2, C59.2, IC16.4, IC17.4, IC18.4, IC20.8
+15V4: 177.2, +15V4.1, C74.2, IC21.4
-2.5V: 25.1, 28.1, 39.2, 47.2, IC2.5, IC2.7
-2.5V1: 67.1, 70.1, 77.2, 83.2, IC7.5, IC7.7
-2.5V2: 111.1, 114.1, 121.2, 127.2, IC12.5, IC12.7
-2.5V3: 155.1, 158.1, 165.2, 171.2, IC17.5, IC17.7
-15V: 56.1, -15V.1, C12.1, C13.1, C14.1, C15.1, IC1.11, IC2.11, IC3.11, IC4.4
-15V1: 88.1, -15V1.1, C28.1, C29.1, C30.1, C31.1, IC6.11, IC7.11, IC8.11, IC10.4
-15V2: 132.1, -15V2.1, C44.1, C45.1, C46.1, C47.1, IC11.11, IC12.11, IC13.11, IC15.4
-15V3: 176.1, -15V3.1, C60.1, C61.1, C62.1, C63.1, IC16.11, IC17.11, IC18.11, IC20.4
-15V4: -15V4.1, C75.1, IC21.11
AMP_CV: 4.2, 5.2, PULSE_AMP_CV.1
AMP_CV1: 32.2, 33.2, PULSE_AMP_CV1.1
AMP_CV2: 92.2, 93.2, PULSE_AMP_CV2.1
AMP_CV3: 136.2, 137.2, PULSE_AMP_CV3.1
DCO_IN: 10.1, DCO_IN.1
DCO_IN1: 51.1, DCO_IN1.1
DCO_IN2: 97.1, DCO_IN2.1
DCO_IN3: 141.1, DCO_IN3.1
GND: 2.1, 6.2, 19.2, 22.2, 36.1, 50.2, 55.2, C5.1, C6.1, C8.1, C9.1, C10.1, C11.1, C12.2, C13.2, C14.2, C15.2, C16.1, D3.C, D4.A, GND.1, GND27.1, IC1.3, IC1.10, IC2.3, IC2.12, IC3.3, IC3.5, IC3.10, IC3.12, IC4.3, IC4.5, IC5.4, IC5.6, IC5.7, IC5.8, IC5.10, T1.E
GND1: 21.1, 34.2, 62.2, 64.2, 74.1, 86.2, 87.2, C21.1, C22.1, C24.1, C25.1, C26.1, C27.1, C28.2, C29.2, C30.2, C31.2, C32.1, D7.C, D8.A, GND1.1, GND2.1, IC6.3, IC6.10, IC7.3, IC7.12, IC8.3, IC8.5, IC8.10, IC8.12, IC9.4, IC9.6, IC9.7, IC9.8, IC9.10, IC10.3, IC10.5, T2.E
GND2: 90.1, 94.2, 106.2, 108.2, 118.1, 130.2, 131.2, C37.1, C38.1, C40.1, C41.1, C42.1, C43.1, C44.2, C45.2, C46.2, C47.2, C48.1, D11.C, D12.A, GND3.1, GND4.1, IC11.3, IC11.10, IC12.3, IC12.12, IC13.3, IC13.5, IC13.10, IC13.12, IC14.4, IC14.6, IC14.7, IC14.8, IC14.10, IC15.3, IC15.5, T3.E
GND3: 134.1, 138.2, 150.2, 152.2, 162.1, 174.2, 175.2, C53.1, C54.1, C56.1, C57.1, C58.1, C59.1, C60.2, C61.2, C62.2, C63.2, C64.1, D15.C, D16.A, GND5.1, GND6.1, IC16.3, IC16.10, IC17.3, IC17.12, IC18.3, IC18.5, IC18.10, IC18.12, IC19.4, IC19.6, IC19.7, IC19.8, IC19.10, IC20.3, IC20.5, T4.E
GND4: 178.2, 180.2, 181.1, 183.1, 188.2, 189.1, C68.1, C69.1, C70.1, C71.1, C72.1, C74.1, C75.2, GND7.1, IC21.5
unnamed: 1.1, 2.2, IC1.12
unnamed: 3.2, IC1.14
unnamed: 3.1, T1.B
unnamed: 4.1, 7.1, T1.C
unnamed: 5.1, 6.1, IC1.5
unnamed: 7.2, 8.1, C7.1, IC1.6
unnamed: 8.2, C7.2, IC1.7, PULSE.1
unnamed: 9.1, 21.2, IC6.12
unnamed: 11.2, 12.1, 14.1, 23.1, IC1.1, IC1.13, INV_SAW.1
unnamed: 10.2, 11.1, CENTER.1, IC1.2
unnamed: 12.2, 13.1, D1.C, IC1.9
unnamed: D1.A, D2.C, IC1.8
unnamed: 13.2, 15.2, D2.A
unnamed: 14.2, 15.1, 16.1, 17.2, IC2.13
unnamed: 23.2, 24.1, IC2.2
unnamed: 24.2, 35.1, IC2.1, SAW.1
unnamed: 29.2, C2.2, IC4.7, SUB_SQR_1.1
unnamed: 30.2, C1.2, IC4.1, SUB_SQR_2.1
unnamed: 25.2, 26.2, 29.1, C2.1, IC4.6
unnamed: 46.2, IC3.7, ST4.1
unnamed: 48.2, 49.2, 50.1
unnamed: 27.2, 28.2, 30.1, C1.1, IC4.2
unnamed: 35.2, 36.2, 37.2
unnamed: 37.1, IC3.9, ST1.1
unnamed: 31.2, IC6.14
unnamed: 38.1, 39.1, 40.2, 41.1, C3.1, IC3.13
unnamed: 41.2, 49.1, C3.2, IC3.14, SUB_SAW_1.1
unnamed: 48.1, IC3.6, ST3.1
unnamed: 44.1, 45.1, 46.1, 47.1, C4.1, IC3.2
unnamed: 44.2, C4.2, IC3.1, SUB_SAW_2.1
unnamed: C6.2, IC5.2, IC5.5
unnamed: 26.1, 40.1, IC5.1, IC5.11
unnamed: 55.1, 56.2, IC2.6
unnamed: C5.2, IC5.9, IC5.12
unnamed: 27.1, 45.2, IC5.13
unnamed: 19.1, 20.2, IC2.9
unnamed: 16.2, SYMMETRY.1
unnamed: 17.1, 18.2, IC2.14, TRIANGLE.1
unnamed: 18.1, 22.1, D3.A, D4.C, IC2.10
unnamed: 20.1, IC2.8, SINE.1
unnamed: 38.2, IC3.8, ST2.1
unnamed: 31.1, T2.B
unnamed: 32.1, 42.1, T2.C
unnamed: 33.1, 34.1, IC6.5
unnamed: 42.2, 43.1, C23.1, IC6.6
unnamed: 43.2, C23.2, IC6.7, PULSE1.1
unnamed: 52.2, 53.1, 57.1, 65.1, IC6.1, IC6.13, INV_SAW1.1
unnamed: 51.2, 52.1, CENTER1.1, IC6.2
unnamed: 53.2, 54.1, D5.C, IC6.9
unnamed: D5.A, D6.C, IC6.8
unnamed: 54.2, 58.2, D6.A
unnamed: 57.2, 58.1, 59.1, 60.2, IC7.13
unnamed: 65.2, 66.1, IC7.2
unnamed: 66.2, 73.1, IC7.1, SAW1.1
unnamed: 71.2, C18.2, IC10.7, SUB_SQR_3.1
unnamed: 72.2, C17.2, IC10.1, SUB_SQR_4.1
unnamed: 67.2, 68.2, 71.1, C18.1, IC10.6
unnamed: 69.2, 70.2, 72.1, C17.1, IC10.2
unnamed: 73.2, 74.2, 75.2
unnamed: 75.1, IC8.9, ST5.1
unnamed: 76.1, 77.1, 78.2, 79.1, C19.1, IC8.13
unnamed: 79.2, 85.1, C19.2, IC8.14, SUB_SAW_3.1
unnamed: 82.2, IC8.7, ST8.1
unnamed: 84.2, 85.2, 86.1
unnamed: 84.1, IC8.6, ST7.1
unnamed: 80.1, 81.1, 82.1, 83.1, C20.1, IC8.2
unnamed: 80.2, C20.2, IC8.1, SUB_SAW_4.1
unnamed: 87.1, 88.2, IC7.6
unnamed: C22.2, IC9.2, IC9.5
unnamed: 68.1, 78.1, IC9.1, IC9.11
unnamed: C21.2, IC9.9, IC9.12
unnamed: 69.1, 81.2, IC9.13
unnamed: 60.1, 61.2, IC7.14, TRIANGLE1.1
unnamed: 61.1, 64.1, D7.A, D8.C, IC7.10
unnamed: 62.1, 63.2, IC7.9
unnamed: 63.1, IC7.8, SINE1.1
unnamed: 59.2, SYMMETRY1.1
unnamed: 76.2, IC8.8, ST6.1
unnamed: 89.1, 90.2, IC11.12
unnamed: 91.2, IC11.14
unnamed: 91.1, T3.B
unnamed: 92.1, 95.1, T3.C
unnamed: 93.1, 94.1, IC11.5
unnamed: 95.2, 96.1, C39.1, IC11.6
unnamed: 96.2, C39.2, IC11.7, PULSE2.1
unnamed: 98.2, 99.1, 101.1, 109.1, IC11.1, IC11.13, INV_SAW2.1
unnamed: 97.2, 98.1, CENTER2.1, IC11.2
unnamed: 99.2, 100.1, D9.C, IC11.9
unnamed: D9.A, D10.C, IC11.8
unnamed: 100.2, 102.2, D10.A
unnamed: 101.2, 102.1, 103.1, 104.2, IC12.13
unnamed: 109.2, 110.1, IC12.2
unnamed: 110.2, 117.1, IC12.1, SAW2.1
unnamed: 115.2, C34.2, IC15.7, SUB_SQR_5.1
unnamed: 116.2, C33.2, IC15.1, SUB_SQR_6.1
unnamed: 111.2, 112.2, 115.1, C34.1, IC15.6
unnamed: 113.2, 114.2, 116.1, C33.1, IC15.2
unnamed: 117.2, 118.2, 119.2
unnamed: 119.1, IC13.9, ST9.1
unnamed: 120.1, 121.1, 122.2, 123.1, C35.1, IC13.13
unnamed: 123.2, 129.1, C35.2, IC13.14, SUB_SAW_5.1
unnamed: 126.2, IC13.7, ST12.1
unnamed: 128.2, 129.2, 130.1
unnamed: 128.1, IC13.6, ST11.1
unnamed: 124.1, 125.1, 126.1, 127.1, C36.1, IC13.2
unnamed: 124.2, C36.2, IC13.1, SUB_SAW_6.1
unnamed: 131.1, 132.2, IC12.6
unnamed: C38.2, IC14.2, IC14.5
unnamed: 112.1, 122.1, IC14.1, IC14.11
unnamed: C37.2, IC14.9, IC14.12
unnamed: 113.1, 125.2, IC14.13
unnamed: 104.1, 105.2, IC12.14, TRIANGLE2.1
unnamed: 105.1, 108.1, D11.A, D12.C, IC12.10
unnamed: 106.1, 107.2, IC12.9
unnamed: 107.1, IC12.8, SINE2.1
unnamed: 103.2, SYMMETRY2.1
unnamed: 120.2, IC13.8, ST10.1
unnamed: 133.1, 134.2, IC16.12
unnamed: 135.2, IC16.14
unnamed: 135.1, T4.B
unnamed: 136.1, 139.1, T4.C
unnamed: 137.1, 138.1, IC16.5
unnamed: 139.2, 140.1, C55.1, IC16.6
unnamed: 140.2, C55.2, IC16.7, PULSE3.1
unnamed: 142.2, 143.1, 145.1, 153.1, IC16.1, IC16.13, INV_SAW3.1
unnamed: 141.2, 142.1, CENTER3.1, IC16.2
unnamed: 143.2, 144.1, D13.C, IC16.9
unnamed: D13.A, D14.C, IC16.8
unnamed: 144.2, 146.2, D14.A
unnamed: 145.2, 146.1, 147.1, 148.2, IC17.13
unnamed: 153.2, 154.1, IC17.2
unnamed: 154.2, 161.1, IC17.1, SAW3.1
unnamed: 159.2, C50.2, IC20.7, SUB_SQR_7.1
unnamed: 160.2, C49.2, IC20.1, SUB_SQR_8.1
unnamed: 155.2, 156.2, 159.1, C50.1, IC20.6
unnamed: 157.2, 158.2, 160.1, C49.1, IC20.2
unnamed: 161.2, 162.2, 163.2
unnamed: 163.1, IC18.9, ST13.1
unnamed: 164.1, 165.1, 166.2, 167.1, C51.1, IC18.13
unnamed: 167.2, 173.1, C51.2, IC18.14, SUB_SAW_7.1
unnamed: 170.2, IC18.7, ST16.1
unnamed: 172.2, 173.2, 174.1
unnamed: 172.1, IC18.6, ST15.1
unnamed: 168.1, 169.1, 170.1, 171.1, C52.1, IC18.2
unnamed: 168.2, C52.2, IC18.1, SUB_SAW_8.1
unnamed: 175.1, 176.2, IC17.6
unnamed: C54.2, IC19.2, IC19.5
unnamed: 156.1, 166.1, IC19.1, IC19.11
unnamed: C53.2, IC19.9, IC19.12
unnamed: 157.1, 169.2, IC19.13
unnamed: 148.1, 149.2, IC17.14, TRIANGLE3.1
unnamed: 149.1, 152.1, D15.A, D16.C, IC17.10
unnamed: 150.1, 151.2, IC17.9
unnamed: 151.1, IC17.8, SINE3.1
unnamed: 147.2, SYMMETRY3.1
unnamed: 164.2, IC18.8, ST14.1
unnamed: 178.1, 179.2, IC21.2, LEVEL1.1
unnamed: 181.2, 182.1, IC21.13
unnamed: 189.2, 190.1, IC21.9
unnamed: 185.2, C68.2
unnamed: 186.2, C69.2
unnamed: 187.2, C70.2
unnamed: 177.1, C65.1, NOISE_IN.1
unnamed: 180.1, C65.2, IC21.3
unnamed: 179.1, C66.1, IC21.1, LEVEL2.1
unnamed: 183.2, C66.2, IC21.12
unnamed: 182.2, C67.1, IC21.14, WHITE_OUT.1
unnamed: 184.1, 185.1, 186.1, 187.1, 188.1, C71.2, IC21.10
unnamed: 184.2, C67.2
unnamed: 190.2, 191.1, IC21.8, PINK_OUT.1
unnamed: 191.2, 192.1, 193.1, C72.2
unnamed: 193.2, C73.2, IC21.6
unnamed: 192.2, C73.1, IC21.7, RED_OUT.1
PW_CV: 1.2, PW_CV.1
PW_CV1: 9.2, PW_CV1.1
PW_CV2: 89.2, PW_CV2.1
PW_CV3: 133.2, PW_CV3.1
SQR: DCO_TIMER.1, IC5.3
SQR1: DCO_TIMER1.1, IC9.3
SQR2: DCO_TIMER2.1, IC14.3
SQR3: DCO_TIMER3.1, IC19.3
