xonik/waveshaper-pcb/(commit log)

2017-09-25 Initial schematics for waveshaper
    [Xonik Waveformer v1.0.brd, Xonik Waveformer v1.0.sch]
2017-09-27 Working with board layout
    [Xonik Waveformer v1.0.brd, Xonik Waveformer v1.0.sch]
2017-09-28 Still doing layout
    [Xonik Waveformer v1.0.brd, Xonik Waveformer v1.0.sch]
2017-09-28 Routing complete except for bypass caps
    [Xonik Waveformer v1.0.brd, Xonik Waveformer v1.0.sch]
2017-09-29 Finished tracing, working on labels
    [Xonik Waveformer v1.0.brd, Xonik Waveformer v1.0.sch]
2017-09-30 Trace and text complete, gp and logo missing
    [Xonik Waveformer v1.0.brd, Xonik Waveformer v1.0.sch]
2017-10-03 Renamed. Tested 330k resistor and pulse input, updated schematics. Comparison to breadboarded circuit still needed, then only logo and gp is remaining
    [Xonik Waveshaper v1.0.brd, Xonik Waveshaper v1.0.sch]
2017-10-05 Probably final version before adding gp and stuff
    [Xonik Waveshaper v1.0-take 2.brd, Xonik Waveshaper v1.0-take 2.sch]
2017-10-05 Added ground plane
    [Xonik Waveshaper v1.0 w gp.brd, Xonik Waveshaper v1.0 w gp.sch]
2017-10-06 Added logo, only panelizing is missing
    [Xonik Waveshaper v1.0 w gp.brd]
2018-01-27 New versions
    [Xonik Waveshaper v1.0 w gp panelized 2 ordered 20171010.brd, Xonik Waveshaper v1.0 w gp panelized 2.brd, Xonik Waveshaper v1.0 w gp panelized.brd, Xonik Waveshaper v1.0 w gp.brd, Xonik Waveshaper v1.0 w gp.sch, Xonik Waveshaper v1.0.brd, Xonik Waveshaper v1.0.sch]
2020-02-12 Testing jlcpcb
    [Xonik Waveshaper v1.0 w gp_top_bom.csv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]
2020-02-12 Added part numbers
    [Xonik Waveshaper v1.0 w gp_top_bom.csv]
2020-02-14 Added version 2 of waveshaper, adds a screw hole, moves bypass caps to top and only uses one cap for opamps (per Small/Yusynth). Changes most entry points to ends for resistors/caps
    [Xonik Waveshaper v2.0.brd, Xonik Waveshaper v2.0.sch]
2020-02-17 Vector xonik logo
    [Xonik Waveshaper v2.0.brd]
2020-02-18 Added bom
    [Xonik Waveshaper v2.0_top_bom.csv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]
2020-02-18 Better clearance around bypass caps
    [Xonik Waveshaper v2.0.brd]
2020-02-18 Updated parts list after parts moved
    [Xonik Waveshaper v2.0_top_cpl.csv]
2020-02-20 Split dedication and version
    [Xonik Waveshaper v2.0.brd]
2020-02-20 Silk screen tweak
    [Xonik Waveshaper v2.0.brd, Xonik Waveshaper v2.0.sch]
2020-02-22 Changed to logo-as-component
    [Xonik Waveshaper v2.0.brd]
2020-02-22 Slight silk adjustment
    [Xonik Waveshaper v2.0.brd]
2020-02-23 Added info about trimmer value
    [Xonik Waveshaper v2.0.brd, Xonik Waveshaper v2.0.sch]
2020-03-02 Added bom and gerber
    [Xonik Waveshaper v2.0.brd, Xonik Waveshaper v2.0.sch, Xonik Waveshaper v2.0_top_bom_2020-03-02.csv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]
2020-06-16 v2.1 - fixed serious bug, had mixed up + and - on -2.5v generator op amp
    [Xonik Waveshaper v2.1.brd, Xonik Waveshaper v2.1.sch]
2020-06-21 Replaced 1.5k R19 with 1.2k for a sine closer to +/-5v
    [Xonik Waveshaper v2.1.brd, Xonik Waveshaper v2.1.sch]
2023-12-12 will remove resistor divider
    [Xonik Waveshaper v2.1.brd, Xonik Waveshaper v2.1.sch]
2023-12-25 Split connector into 19p + 5p to use available from JLCPB
    [Xonik Waveshaper v2.1.brd, Xonik Waveshaper v2.1.sch]
2023-12-26 Changed pin spacing to 2.54mm to still fit breadboard
    [Xonik Waveshaper v2.1.brd]
2023-12-26 Changed comment about flipflop voltage
    [Xonik Waveshaper v2.1.sch]
2023-12-26 Changed to R0603 and 3v3 operation
    [Xonik Waveshaper v2.1.brd, Xonik Waveshaper v2.1.sch]
2024-02-22 Updated component values after simulation
    [Xonik Waveshaper v2.1.brd, Xonik Waveshaper v2.1.sch]
2024-02-22 Changed size and number of decoupling caps
    [Xonik Waveshaper v2.1.brd, Xonik Waveshaper v2.1.sch]
2024-02-25 Version 2.2 that does not need digital voltage and pulse input
    [Xonik Waveshaper v2.2.brd, Xonik Waveshaper v2.2.sch]
2024-02-27 Reduced footprints for op amps
    [Xonik Waveshaper v2.2.brd, Xonik Waveshaper v2.2.sch]
2024-02-28 Almost all tracing done!
    [Xonik Waveshaper v2.2.brd, Xonik Waveshaper v2.2.sch]
2024-02-28 Finished tracing but not satisfied with placement of GND
    [Xonik Waveshaper v2.2.brd]
2024-02-28 Fixed GND placement
    [Xonik Waveshaper v2.2.brd]
2024-02-28 Better ordering of outputs
    [Xonik Waveshaper v2.2.brd]
2024-02-29 Trying to normalize
    [Xonik Waveshaper v2.2.brd]
2024-02-29 Fixed part names
    [Xonik Waveshaper v2.2.brd]
2024-02-29 Cleaned up and error checked
    [Xonik Waveshaper v2.2.brd]
2024-03-01 Changed waveshaper to -5V
    [Xonik Waveshaper v2.2.brd, Xonik Waveshaper v2.2.sch]
2024-04-16 Changed pins to smaller ones
    [Xonik Waveshaper v2.2.brd, Xonik Waveshaper v2.2.sch]
2024-04-28 Comment about bipolar PWM
    [Xonik Waveshaper v2.2.sch]
2024-05-18 Updated with bipolar pwm
    [Xonik Waveshaper v2.2.brd, Xonik Waveshaper v2.2.sch]
2024-05-28 prepared for single connector
    [Xonik Waveshaper v2.2.sch]
2024-05-29 Switched to single connector
    [Xonik Waveshaper v2.2.brd, Xonik Waveshaper v2.2.sch]
2024-05-31 Updated footprints
    [Xonik Waveshaper v2.2.brd, Xonik Waveshaper v2.2.sch]
2024-06-02 Checked with JLCPCB
    [Xonik Waveshaper v2.2.brd, Xonik Waveshaper v2.2.sch]
2024-06-04 Changed to standard value on waveshaper comparator pullup
    [Xonik Waveshaper v2.2.brd, Xonik Waveshaper v2.2.sch]
2024-06-08 Updated caps and footprint
    [Xonik Waveshaper v2.2.sch]
2024-06-24 Replaced LM311 with SO08 because TSSOP is sold out at JLCPCB
    [Xonik Waveshaper v2.2.brd, Xonik Waveshaper v2.2.sch]
2024-06-25 Increased via outer diameter
    [Xonik Waveshaper v2.2.brd]
2024-11-29 Info about trimming
    [Xonik Waveshaper v2.2.sch]
2024-12-07 Added v2.3 of waveshaper to allow for C0G 100nF caps
    [Xonik Waveshaper v2.3.brd, Xonik Waveshaper v2.3.sch]
2024-12-30 Replaced LM311 with op amp comparator
    [Xonik Waveshaper v2.3.brd, Xonik Waveshaper v2.3.sch]
2024-12-30 Routed new version of comparator
    [Xonik Waveshaper v2.3.brd, Xonik Waveshaper v2.3.sch]
2024-12-31 Improved cap footprint
    [Xonik Waveshaper v2.3.brd, Xonik Waveshaper v2.3.sch]
2025-01-02 Comment about testing
    [Xonik Waveshaper v2.3.sch]
2025-01-21 Fixed polarity issue on square wave output
    [Xonik Waveshaper v2.3.brd, Xonik Waveshaper v2.3.sch]
2025-07-07 v2.4, fixes ground plane noise
    [Xonik Waveshaper v2.4.brd, Xonik Waveshaper v2.4.sch]
2025-07-07 Preparing for doing 4 layer board
    [Xonik Waveshaper v2.4.brd]
2025-08-01 Converted to 4 layer and fixed all issues
    [Xonik Waveshaper v2.4.brd, Xonik Waveshaper v2.4.sch]
2025-08-01 Fixed silk screen
    [Xonik Waveshaper v2.4.brd]
2025-08-10 V2.4 4-layer, bom and gerber tested ok
    [Xonik Waveshaper v2.2_top_bom.csv, Xonik Waveshaper v2.2_top_bom_populated.csv, Xonik Waveshaper v2.4_top_bom.csv, Xonik Waveshaper v2.4_top_bom_populated.csv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]
